kscason/Happy_Hands-EE3-/README.md

# Happy_Hands-EE3-
EE3 Final Project: ASL to Text Signing Glove

See Final Report PDF for documentation.

Arduino Sketches written in C++ (see final report), Display and Learning code written in Python.
